lukasznowarkiewicz/tablet-pc-flexible-side-buttons/design_files/Tablet-PC-side-buttons_v7_1.dxf

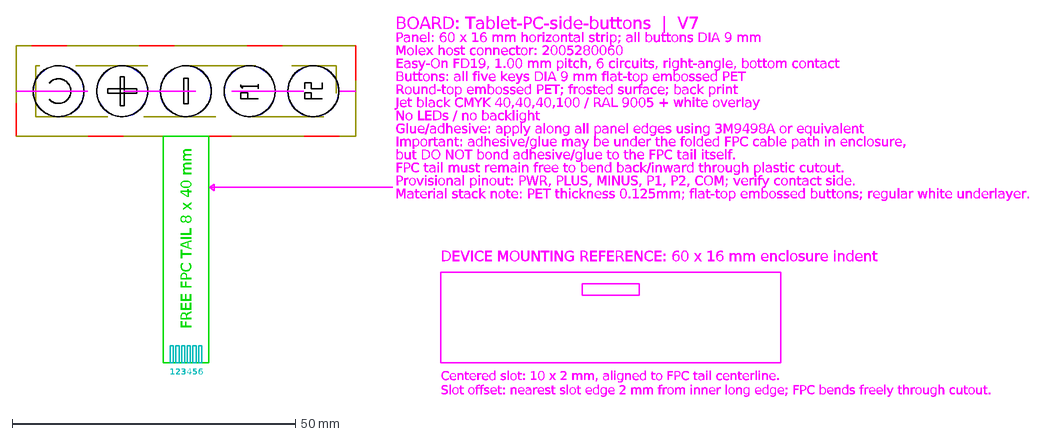
[picture p20: CAD file, 2026-08-02]
design_files/Tablet-PC-side-buttons_v7_1.dxf
FREE FPC TAIL 8 x 40 mm
1
2
3
4
5
6
BOARD: Tablet-PC-side-buttons | V7
Panel: 60 x 16 mm horizontal strip; all buttons DIA 9 mm
Molex host connector: 2005280060
Easy-On FD19, 1.00 mm pitch, 6 circuits, right-angle, bottom contact
Buttons: all five keys DIA 9 mm flat-top embossed PET
Round-top embossed PET; frosted surface; back print
Jet black CMYK 40,40,40,100 / RAL 9005 + white overlay
No LEDs / no backlight
Glue/adhesive: apply along all panel edges using 3M9498A or equivalent
Important: adhesive/glue may be under the folded FPC cable path in enclosure,
but DO NOT bond adhesive/glue to the FPC tail itself.
FPC tail must remain free to bend back/inward through plastic cutout.
Provisional pinout: PWR, PLUS, MINUS, P1, P2, COM; verify contact side.
Material stack note: PET thickness 0.125mm; flat-top embossed buttons; regular white underlayer.
DEVICE MOUNTING REFERENCE: 60 x 16 mm enclosure indent
Centered slot: 10 x 2 mm, aligned to FPC tail centerline.
Slot offset: nearest slot edge 2 mm from inner long edge; FPC bends freely through cutout.
