lukasznowarkiewicz/tablet-pc-flexible-side-buttons/design_files/Tablet-PC-side-buttons_v3.dxf

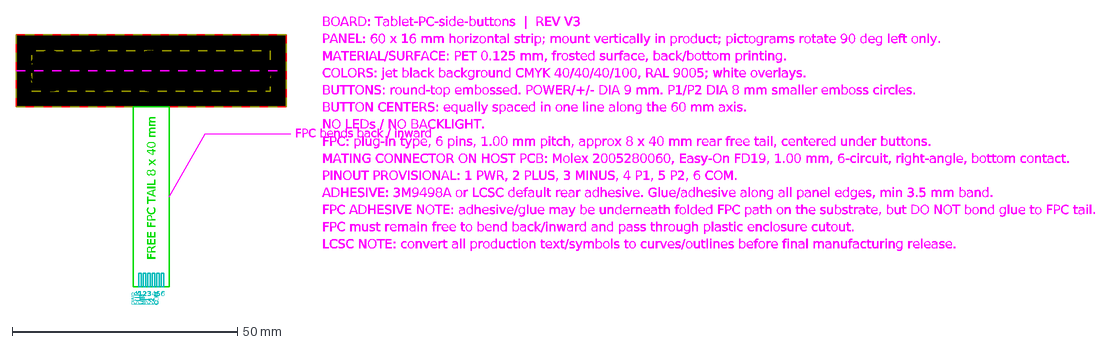
[picture p21: CAD file, 2026-08-02, an earlier design]
design_files/Tablet-PC-side-buttons_v3.dxf
FREE FPC TAIL 8 x 40 mm
P1
P2
1
PWR
2
PLUS
3
MIN
4
5
6
COM
BOARD: Tablet-PC-side-buttons | REV V3
PANEL: 60 x 16 mm horizontal strip; mount vertically in product; pictograms rotate 90 deg left only.
MATERIAL/SURFACE: PET 0.125 mm, frosted surface, back/bottom printing.
COLORS: jet black background CMYK 40/40/40/100, RAL 9005; white overlays.
BUTTONS: round-top embossed. POWER/+/- DIA 9 mm. P1/P2 DIA 8 mm smaller emboss circles.
BUTTON CENTERS: equally spaced in one line along the 60 mm axis.
NO LEDs / NO BACKLIGHT.
FPC: plug-in type, 6 pins, 1.00 mm pitch, approx 8 x 40 mm rear free tail, centered under buttons.
MATING CONNECTOR ON HOST PCB: Molex 2005280060, Easy-On FD19, 1.00 mm, 6-circuit, right-angle, bottom contact.
PINOUT PROVISIONAL: 1 PWR, 2 PLUS, 3 MINUS, 4 P1, 5 P2, 6 COM.
ADHESIVE: 3M9498A or LCSC default rear adhesive. Glue/adhesive along all panel edges, min 3.5 mm band.
FPC ADHESIVE NOTE: adhesive/glue may be underneath folded FPC path on the substrate, but DO NOT bond glue to FPC tail.
FPC must remain free to bend back/inward and pass through plastic enclosure cutout.
LCSC NOTE: convert all production text/symbols to curves/outlines before final manufacturing release.
FPC bends back / inward
