lukasznowarkiewicz/tablet-pc-flexible-side-buttons/design_files/Tablet-PC-side-buttons_v5.dxf

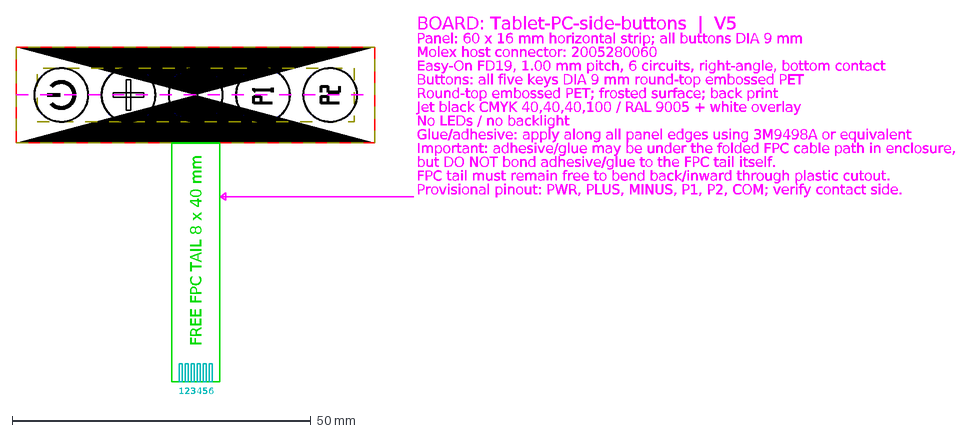
[picture p22: CAD file, 2026-08-02, an earlier design]
design_files/Tablet-PC-side-buttons_v5.dxf
FREE FPC TAIL 8 x 40 mm
1
2
3
4
5
6
BOARD: Tablet-PC-side-buttons | V5
Panel: 60 x 16 mm horizontal strip; all buttons DIA 9 mm
Molex host connector: 2005280060
Easy-On FD19, 1.00 mm pitch, 6 circuits, right-angle, bottom contact
Buttons: all five keys DIA 9 mm round-top embossed PET
Round-top embossed PET; frosted surface; back print
Jet black CMYK 40,40,40,100 / RAL 9005 + white overlay
No LEDs / no backlight
Glue/adhesive: apply along all panel edges using 3M9498A or equivalent
Important: adhesive/glue may be under the folded FPC cable path in enclosure,
but DO NOT bond adhesive/glue to the FPC tail itself.
FPC tail must remain free to bend back/inward through plastic cutout.
Provisional pinout: PWR, PLUS, MINUS, P1, P2, COM; verify contact side.
