lukasznowarkiewicz/tablet-pc-flexible-side-buttons/(list of files, cad)

Other CAD files:
design_files/Tablet-PC-side-buttons_v6.dxf
design_files/Tablet-PC-side-buttons_v2.dxf
design_files/Tablet-PC-side-buttons_v1.dxf
